Noack-Oy/fnx51/README.md

# fnx51
8051-based SBC with VGA graphics (no FPGA)
