Noack-Oy/fnx51/docs/test/index.markdown

Test index in subdirectory

{% include_relative test.lst.md %}
