Noack-Oy/fnx51/docs/test/test.lst.md

```
0000: 43 87 80              orl     PCON,   #0x80
```
