Noack-Oy/fnx51/docs/test/test.markdown

This is a test.

{% include_relative test2.md %}
