Noack-Oy/fnx51/(commit log)

2024-07-01 add pcb files
    [fnx51.kicad_pcb, fnx51.kicad_sch]
2024-07-01 add hierarchical schematic for video hardware
    [fnx51.kicad_sch, video.kicad_sch]
2024-10-16 schematic: video signals, address counter, extra registers
    [10bitcount.kicad_sch, comp_ff.kicad_sch, fnx51.kicad_sch, video.kicad_sch, xregs.kicad_sch]
2024-10-27 WIP schematic
    [copro.kicad_sch, ethernet.kicad_sch, fnx51.kicad_sch, video.kicad_sch, xregs.kicad_sch]
2024-12-05 add missing file, improve loader
    [loader.py]
2024-12-05 add extra test case
2025-01-18 WIP PCB
    [10bitcount.kicad_sch, 11bitcount.kicad_sch, audio.kicad_sch, comp_ff.kicad_sch, copro.kicad_sch, ethernet.kicad_sch, filter.kicad_sch, fnx51.kicad_sch]
2025-12-22 PCB: add reset circuit, xtal
    [10bitcount.kicad_sch, 11bitcount.kicad_sch, audio.kicad_sch, comp_ff.kicad_sch, copro.kicad_sch, ethernet.kicad_sch, filter.kicad_sch, fnx51.kicad_sch]
2026-01-04 add signature check to fatfs, improve panic stack trace
2026-02-17 Add FAT32 cluster-to-LBA conversion
    Implement fatfs_cluster_to_lba() to convert cluster numbers to sector
    LBA addresses. The function:
    - Dynamically calculates log2 of cluster_size via bit shifting
    - Validates cluster_size is a power of 2
    - Uses the formula: LBA = cluster_lba + (cluster * cluster_size)
    - Preserves r4-r7 in a register-bank-independent manner
    Add supporting utilities:
    - shl_32() in math/arith32.inc for 32-bit left shifts
    - dptr_index() in util/dptr.inc for structure field access
    Update tests to verify correct conversion with actual SD card layout.
2026-02-22 WIP PCB (add bypass caps, minor fixes)
    [10bitcount.kicad_sch, 11bitcount.kicad_sch, audio.kicad_sch, comp_ff.kicad_sch, copro.kicad_sch, ethernet.kicad_sch, filter.kicad_sch, fnx51.kicad_sch]
2026-05-21 Switch to bank-0 calling convention, drop regbank helpers
    Functions now assume register bank 0 is active at every call boundary
    and save r0-r7 directly via stack pushes (e.g. push 0 for r0) instead
    of switching banks. The regbank_next/regbank_prev helpers are removed.
    Bank 1 is now scratch space for leaf functions; banks 2/3 are reserved
    for interrupts and userspace.
    Also includes the rom.asm revert to a basic hello-world.
    [rom.asm]
2026-05-21 Extend memory test to cover skip-too-small allocation path
    Sets up two free blocks (a small one at the head, a large one
    further along) and requests more than the small block can hold,
    forcing the allocator to traverse past the first block.
    This currently fails: a mov dpl,r5 typo in the traversal step
    (should be mov dph,r5) sends the walk back to memory_list and
    loops forever.
2026-05-21 Drop input-to-scratch shuffle in print_int_u32/s32
    Now that bank 0 is always active, the input no longer has to be
    moved out of the way to make room for the divisor. Keep the value
    in r0-r3 throughout and load the divisor into r4-r7 instead; the
    divide subroutine is flipped to match. Saves the 8-instruction
    "mov a,r0 ; mov r4,a ; ..." chain at function entry.
2026-05-22 Simplify print_text r0 save/restore
    Use push/pop 0 directly instead of shunting r0 through acc.
2026-05-22 Restore tracked print test artifacts removed by failed local tool run
    Agent-Logs-Url: https://github.com/Noack-Oy/fnx51/sessions/9a045e2b-7875-49af-ad93-fe8d27612b74
2026-05-22 Add FAT32 roadmap
    Stash the read-first FAT32 implementation plan for later. The
    fatfs/ layer currently only mounts the volume and converts cluster
    numbers to LBAs; this roadmap sketches three PR-sized read-path
    steps (next-cluster lookup, directory iterator, file open + read)
    followed by a separate writes phase.
2026-05-22 Swap memory_release register roles instead of shuffling at entry
    The previous fix kept the old body layout (addr in r0r1, size in
    r2r3) and moved the input registers around at entry: 4 movs to copy
    size r0r1 -> r2r3 and addr dptr -> r0r1. The proper change is to
    swap which roles the registers play inside the body: size in r0r1
    (matching memory_allocate's input) and addr in r2r3. Only the addr
    needs to be loaded from dptr at entry now (2 movs); size stays in
    place. The temp slot in the touches-next coalescing path is still
    r6 (prev_lo, freed by then) — unchanged.
2026-05-22 Revise FAT32 roadmap: chain handle abstraction in step 1
    Step 1 no longer requires FAT-entry traversal on the reference card.
    It now introduces a chain handle (first cluster + current cluster)
    with an init/deinit-vs-open/close lifecycle so that the dir and file
    handles can extend it via a single allocation. Block access splits
    into ensure_block (borrow into the block cache) and load_block (copy
    convenience); step 1 stubs ensure_block to panic for any block other
    than 0. fatfs_chain_next_cluster is deferred until a caller actually
    needs to cross a cluster boundary.
    Steps 2 and 3 are updated to layer on this: the dir handle embeds
    the chain header plus a 32-byte entry buffer in one allocation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
2026-05-22 Add FAT32 chain handle (roadmap step 1)
    Introduce the chain-handle abstraction over cluster-chain traversal.
    For step 1 the API surface and plumbing are in place but
    fatfs_chain_ensure_block only handles block == 0 (loads the first
    sector of the first cluster); any other block number panics. The
    real traversal — and the fatfs_chain_next_cluster routine that goes
    with it — lands when step 2 or 3 first needs to follow a chain past
    its first cluster.
    Lifecycle convention (mirrored later by dir and file handles, which
    extend the chain handle by adding fields after byte 7):
    *_init — initialize a pre-allocated struct. No allocation.
    *_deinit — release sub-resources. No deallocation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
2026-05-23 Address PR #2 review
    - Add chain.equ alongside info.equ so the chain handle layout is
    available as constants (fatfs_chain_first, _current, _size).
    - Drop push acc / pop acc from chain_init / _open / _close /
    _load_block — none of them touch acc.
    - ensure_block now preserves r0-r3 per the calling convention
    (input parameters that aren't return values stay intact).
    - load_block only saves the registers it actually clobbers
    (r0, for the dptr_copy count).
    - chain test no longer push/pops the handle on the stack — it
    duplicates the handle into dptr' before the ensure_block call,
    which both saves a few bytes and exercises ensure_block's
    contract to preserve dptr'.
    Co-Authored-By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
2026-05-23 Address PR #2 follow-up review
    - fatfs_chain_ensure_block now returns the cached pointer in dptr'
    (the alternate data pointer) and preserves dptr (the handle).
    Callers no longer need to stash the handle across the call — the
    chain test gets simpler and exercises ensure_block's promise to
    preserve dptr.
    - fatfs_chain_load_block uses `dec dph` twice to undo the 512-byte
    dst advance instead of restoring from the stack. Together with the
    new ensure_block contract the function is slightly more involved
    (we have to ferry the handle and the freshly-restored dst into
    their final slots), but stays in the same byte budget and follows
    the suggestion cleanly.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
2026-05-23 Simplify load_block exit: swap slots instead of moving dst
    After dptr_copy + dec dph, slot 0 holds dst and slot 1 holds the
    end-of-loop cached pointer. The calling convention only requires
    dptr and dptr' to logically hold the right values — it doesn't
    care which physical slot they live in. So we just toggle auxr1 to
    make slot 1 active and pop the saved handle into it. The slots
    end up physically swapped relative to entry (slot 0 = dst, slot 1
    = handle), but `dptr` and `dptr'` still resolve to handle and dst
    respectively. Saves the push/pop/swap-then-pop dance that was
    shuffling dst from slot 0 to slot 1.
2026-06-11 Switch assembler from as31 to zinc51
    - Replace `as31 -l` with `zinc51 … -l` in both Makefiles
    - Rename `.inc` include directive to `.include` throughout
    - Fix `movc a, @dptr+a` → `movc a, @a+dptr` (standard 8051 operand order)
    All hardware tests pass.
    [rom.asm]
2026-08-03 update to kicad 10 and fix vertical video timing
    [10bitcount.kicad_sch, 11bitcount.kicad_sch, audio.kicad_sch, comp_ff.kicad_sch, copro.kicad_sch, ethernet.kicad_sch, filter.kicad_sch, fnx51.kicad_sch]
2026-08-03 Remove the stale pcb/.history gitlink, and ignore .history
    pcb/.history was recorded as a gitlink -- index mode 160000, the entry
    type git uses for a submodule -- with no matching .gitmodules entry and
    pointing at commit a8a7a7c, which exists in no repository. git cat-file
    cannot resolve it. The effect is that `git submodule status` fails here
    and `git clone --recursive` would too.
    Nothing was lost, because a gitlink stores only a SHA and never the
    contents. It happens automatically: `git add` on a directory that contains
    its own .git records a gitlink rather than recursing, and .history is the
    VS Code Local History folder, which keeps a repo of its own. It came in
    with the KiCad 10 update.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
2026-08-03 Correct the .history note: it is KiCad's Local History, not VS Code's
    The previous commit blamed the VS Code Local History extension. Wrong.
    The directory carries a README identifying it as KiCad 10's own Local
    History, which is consistent with the gitlink having arrived in the
    "update to kicad 10" commit.
    The mechanism is the same and the generalisation is worth having: for git
    to have recorded a gitlink at all, that directory must contain its own
    .git -- so KiCad manages these snapshots AS A GIT REPOSITORY. Every KiCad
    project kept in version control will therefore grow a nested repo at
    <project>/.history and record it as a submodule with no URL, unless it is
    ignored. This will not be the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
2026-08-05 export and git track netlist
2026-08-05 pcb: errata -- U13 Z1 should be TCC, not ~TCC
    Found while tracing the zoom path to reimplement the scanner on an FPGA.
    U13 is the CD4053 that selects the canvas counters' count enable between
    normal and zoomed. Its Z channel gates the vertical zoom term with the
    per-line tick, and Z1 is wired to ~TCC -- the column counter's sign bit,
    which is high for the whole line and low only at terminal count. As drawn
    the Y address counter is enabled for 799 columns out of 800.
    It wants the active-high terminal count, which U12 gate 2 already
    produces for the Row Counter's CE. With TCC there both zoom modes come
    out right and the two axes are symmetric:
    zoom Y off: C = 1 -> Y CE = TCC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
2026-08-05 fix y coordinate counter input polarity
    [video.kicad_sch]
2026-08-05 pcb/ERRATA: no board exists yet, so say so
    The entry read as though the error had been ruled out by something built.
    Nothing has been laid out -- only the schematic and a partial breadboard.
    Also notes that the fault breaks the normal case rather than the zoomed
    one, so it would have surfaced on first power-up.
2026-08-05 pcb/ERRATA: mark the U13 Z1 entry fixed
    Fixed in 5698968. Notes that pcb/fnx51.net has not been re-exported and
    still carries the old wiring, so anything reading the netlist rather than
    the schematic still sees ~TCC on U13 pin 3.
2026-09-02 rom/test: reach the Pi on its forwarded ssh port
    The router in front of the bench Pi stopped forwarding port 22 on 2026-09-02.
    22078 now lands on the Pi's wired link and 22077 on its wifi, the latter being
    the way back in when a USB host controller wedge takes the wired NIC down with
    it -- on a Pi 3 the ethernet is USB and the wifi is SDIO.
    REMOTE_PORT defaults to 22078 and SSH wraps it, so the ssh and rsync lines pick
    it up without repeating themselves. The comment sits above the assignment rather
    than after it because make folds the whitespace before a trailing '#' into the
    value, which would have handed ssh a port with spaces on the end.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
